xinterface/OpenBCI_ESP32/Firmware/HardwareTests/OpenBCI-ESP32-WiFi-master/README.md

Combined Cyton and WiFi Shield functionality on a single ESP32, replacing the conventional BLE-Serial interface with built-in WiFi.

Required Boards and Libraries:

Arduino-ESP32: https://github.com/espressif/arduino-esp32

ArduinoJson: https://github.com/bblanchon/ArduinoJson
