xinterface/OpenBCI_ESP32/Case/Battery.stl

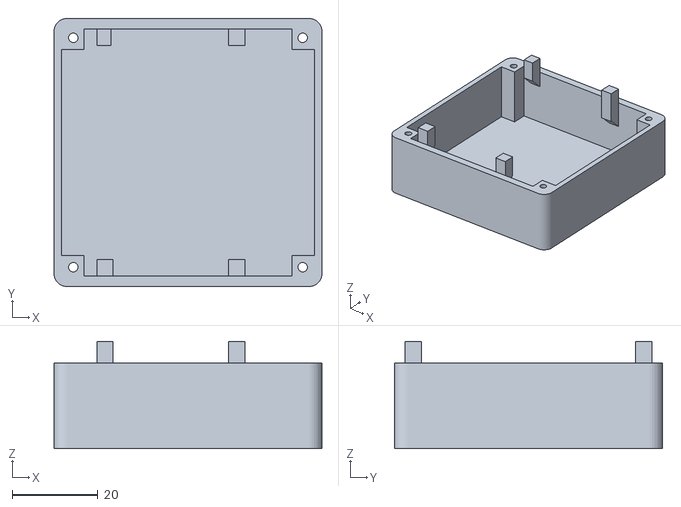
[picture p1: CAD file, 2023-03-15]
Case/Battery.stl
62.5 x 62.5 x 25.0
