xinterface/OpenBCI_ESP32/Case/Switch.stl

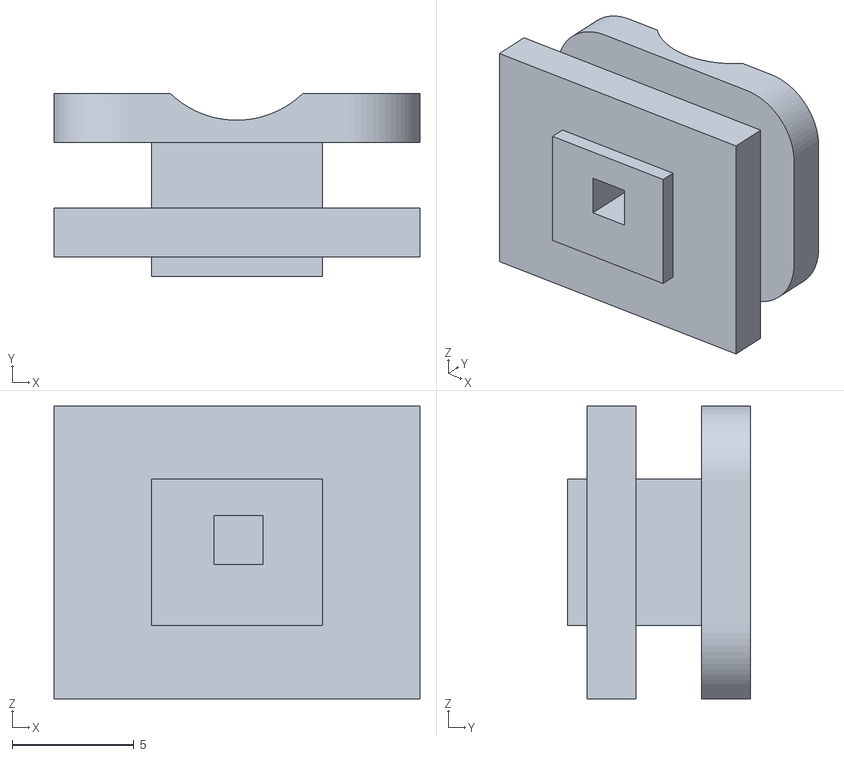
[picture p2: CAD file, 2023-03-15]
Case/Switch.stl
15.0 x 7.50 x 12.0
