xinterface/OpenBCI_ESP32/Case/Base.stl

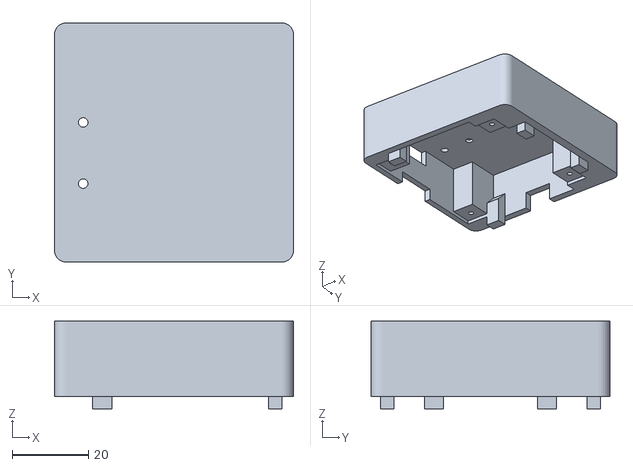
[picture p3: CAD file, 2023-03-15]
Case/Base.stl
62.5 x 62.5 x 22.9
