xinterface/OpenBCI_ESP32/OpenBCI_ESP32_BASE/OpenBCI_ESP32_BASE.kicad_pcb

## KiCad design OpenBCI_ESP32_BASE/OpenBCI_ESP32_BASE.kicad_pcb (2023-03-15)

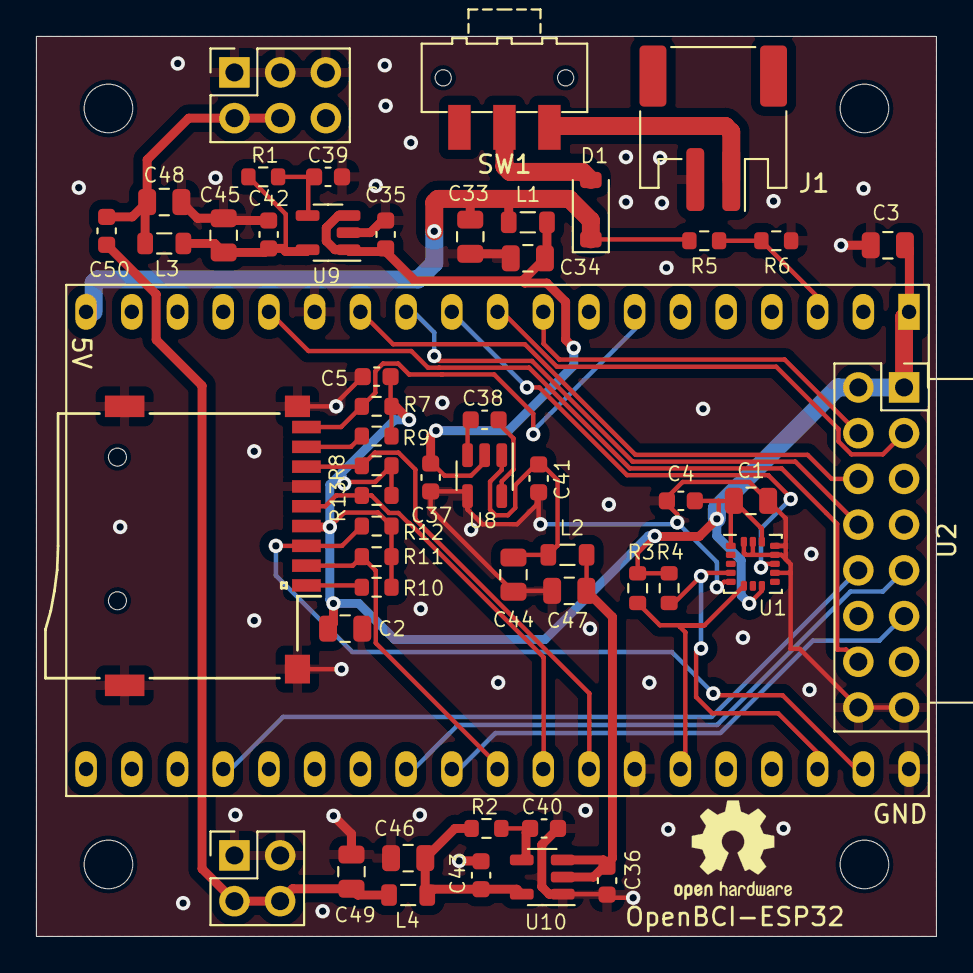
[picture p4: board OpenBCI_ESP32_BASE.kicad_pcb from above]

Board: 2 copper layers, 50.0 x 50.0 mm, 57 parts (0 on the bottom side), 33 nets.

Parts:
C1, C2, C3, C33, C34, C44, C45, C46, C47, C48, C49: 10u; C_0805_2012Metric
C4, C5, C50: 0.1u; C_0603_1608Metric
C35, C37, C38, C39, C41: 1u; C_0603_1608Metric
C36, C42, C43: 2.2u; C_0603_1608Metric
C40: 10n; C_0603_1608Metric
D1: D_Schottky; D_SOD-123
H1, H2, H3, H4: MountingHole; MountingHole_2.7mm_M2.5
J1: Conn_01x02; JST_PH_S2B-PH-SM4-TB_1x02-1MP_P2.00mm_Horizontal
J2: Conn_02x03_Odd_Even; PinHeaderReverse_2x03_P2.54mm_OpenBCI
J3: Conn_02x02_Odd_Even; PinHeaderReverse_2x02_P2.54mml_OpenBCI
J4: Conn_02x08_Odd_Even; PinHeaderReverse_2x08_P2.54mm_OpenBCI
L1, L2, L3, L4: 3.3u; L_0805_2012Metric
LOGO1: Logo_Open_Hardware_Small; OSHW-Logo2_7.3x6mm_SilkScreen
R1, R2: NF; R_0603_1608Metric
R3, R4: 4k7; R_0603_1608Metric
R5: 220k; R_0603_1608Metric
R6: 120k; R_0603_1608Metric
R7, R8, R9, R10, R11, R12, R13: 10k; R_0603_1608Metric
SW1: SW_SPDT; SW_SPDT_CK-JS102011SAQN
U1: LIS3DH; LGA-16_3x3mm_P0.5mm_LayoutBorder3x5y
U2: ESP32-DevKitC
U8: TPS60403; SOT-23-5
U9: TPS73225; SOT-23-5
U10: TPS72325; SOT-23-5
XS1: SD_ebay-uSD-push_push_SMD; Conn_uSDcard

Connections:
+2V5: C48.1, C50.1, J2.2, J2.4, L3.2
+3.3V: C1.1, C2.1, C3.1, C4.1, C5.1, J4.1, J4.2, R3.1, R4.1, R7.1, R8.1, R9.1, R10.1, R11.1, R12.1, R13.1, U1.1 (VDD_IO), U1.8 (CS), U1.14 (VDD), U2.1 (3V3), XS1.4 (Vdd)
+5V: C33.1, D1.1 (K), L1.1, R5.1, U2.19 (5V)
-2V5: C49.1, C50.2, J3.2, J3.4, L4.2
-5V: C36.1, C47.1, L2.2, U10.2 (Vin), U10.3 (EN)
/OpenBCI_ESP_DEVKIT/ADSCLK: J4.8, U2.12 (MTMS/GPIO14/ADC2_CH6)
/OpenBCI_ESP_DEVKIT/ADSCS1: J4.10, U2.23 (*MTDO/GPIO15/ADC2_CH3)
/OpenBCI_ESP_DEVKIT/ADSCS2: J4.9, U2.27 (GPIO16)
/OpenBCI_ESP_DEVKIT/ADSDRDY1: J4.4, U2.9 (DAC_1/ADC2_CH8/GPIO25)
/OpenBCI_ESP_DEVKIT/ADSDRDY2: J4.3, U2.10 (DAC_2/ADC2_CH9/GPIO26)
/OpenBCI_ESP_DEVKIT/ADSMISO: J4.6, U2.13 (*MTDI/GPIO12/ADC2_CH5)
/OpenBCI_ESP_DEVKIT/ADSMOSI: J4.14, U2.15 (MTCK/GPIO13/ADC2_CH4)
/OpenBCI_ESP_DEVKIT/ADSRST: J4.11, U2.28 (GPIO17)
/OpenBCI_ESP_DEVKIT/INT1: U1.11 (INT1), U2.11 (ADC2_CH7/GPIO27)
/OpenBCI_ESP_DEVKIT/SCL: R4.2, U1.4 (SCL/SPC), U2.36 (GPIO22)
/OpenBCI_ESP_DEVKIT/SDA: R3.2, U1.6 (SDA/SDI/SDO), U2.33 (GPIO21)
/OpenBCI_ESP_DEVKIT/SDCD: R7.2, U2.7 (32K_XP/GPIO32/ADC1_CH4), XS1.9 (CD)
/OpenBCI_ESP_DEVKIT/SDCLK: R13.2, U2.30 (GPIO18), XS1.5 (CLK)
/OpenBCI_ESP_DEVKIT/SDCS: R11.2, U2.29 (*GPIO5), XS1.2 (CS/DAT3)
/OpenBCI_ESP_DEVKIT/SDMISO: R8.2, U2.31 (GPIO19), XS1.7 (DO/DAT0)
/OpenBCI_ESP_DEVKIT/SDMOSI: R12.2, U2.37 (GPIO23), XS1.3 (DI/CMD)
GND: C1.2, C2.2, C3.2, C4.2, C5.2, C33.2, C34.2, C35.2, C36.2, C37.2, C39.2, C40.2, C41.2, C42.2, C43.2, C44.2, C45.2, C46.2, C47.2, C48.2, C49.2, J1.2, J2.1, J2.3, J2.5, J3.1, J3.3, J4.15, J4.16, R6.2, U1.5 (GND), U1.10 (GND), U1.12 (GND), U1.13 (ADC3), U1.15 (ADC2), U1.16 (ADC1), U2.14 (GND), U2.32 (GND), U2.38 (GND), U8.4 (Gnd), U9.2 (Gnd), U10.1 (Gnd), XS1.6 (GND)
unnamed: D1.2 (A), SW1.2 (B)
unnamed: J1.1, SW1.1 (A)
unnamed: R5.2, R6.1, U2.3 (SENSOR_VP/GPIO36/ADC1_CH0)
unnamed: C38.1, U8.3 (Cfly1)
unnamed: C38.2, U8.5 (Cfly2)
unnamed: C34.1, C35.1, C37.1, L1.2, U8.2 (Vin), U9.1 (Vin), U9.3 (EN)
unnamed: C41.1, C44.1, L2.1, U8.1 (Vout)
unnamed: C39.1, R1.2, U9.4 (NR)
unnamed: C42.1, C45.1, L3.1, R1.1, U9.5 (Vout)
unnamed: C40.1, R2.2, U10.4 (NR)
unnamed: C43.1, C46.1, L4.1, R2.1, U10.5 (Vout)
