xinterface/OpenBCI_ESP32/OpenBCI_ESP32_ADS1298/OpenBCI_ESP32_ADS1298.kicad_pcb

## KiCad design OpenBCI_ESP32_ADS1298/OpenBCI_ESP32_ADS1298.kicad_pcb (2023-03-15)

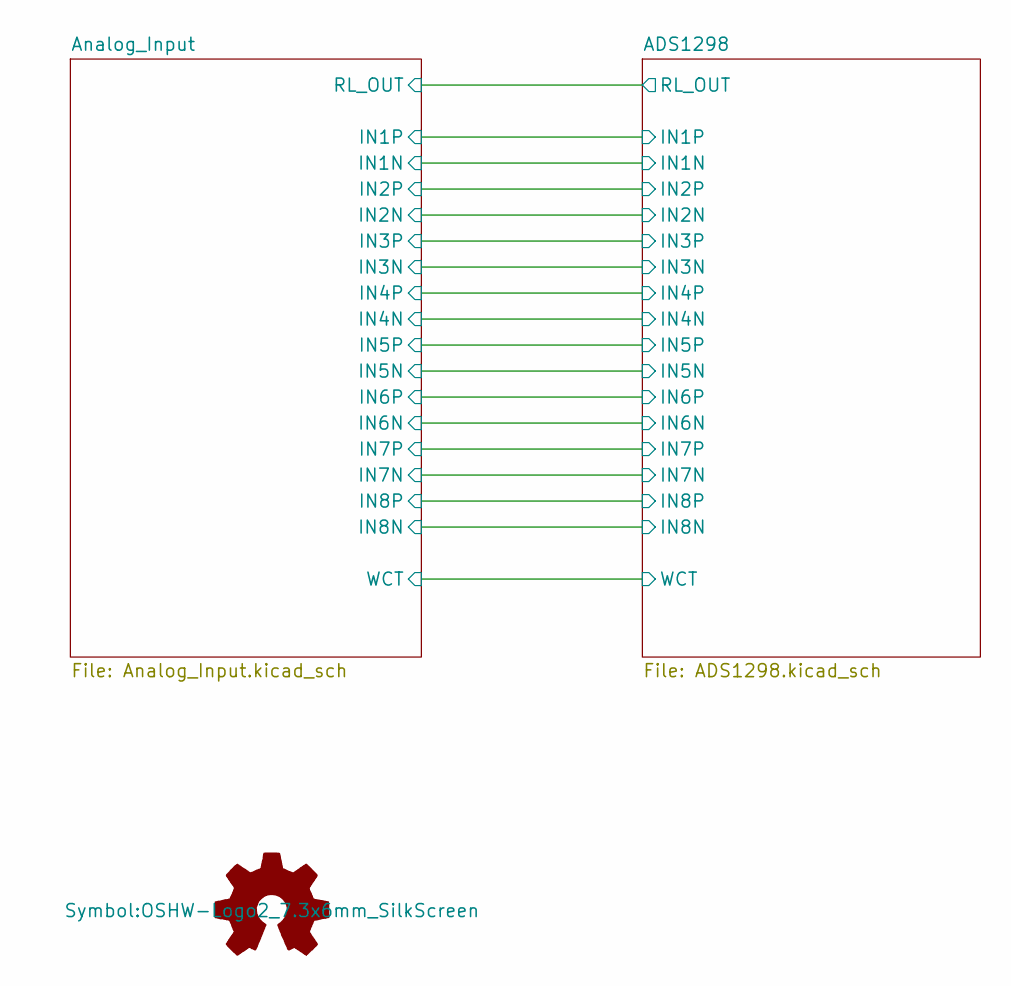
[picture p9: schematic OpenBCI_ESP32_ADS1298.kicad_sch]

Parts:
LOGO1: Logo_Open_Hardware_Small; OSHW-Logo2_7.3x6mm_SilkScreen

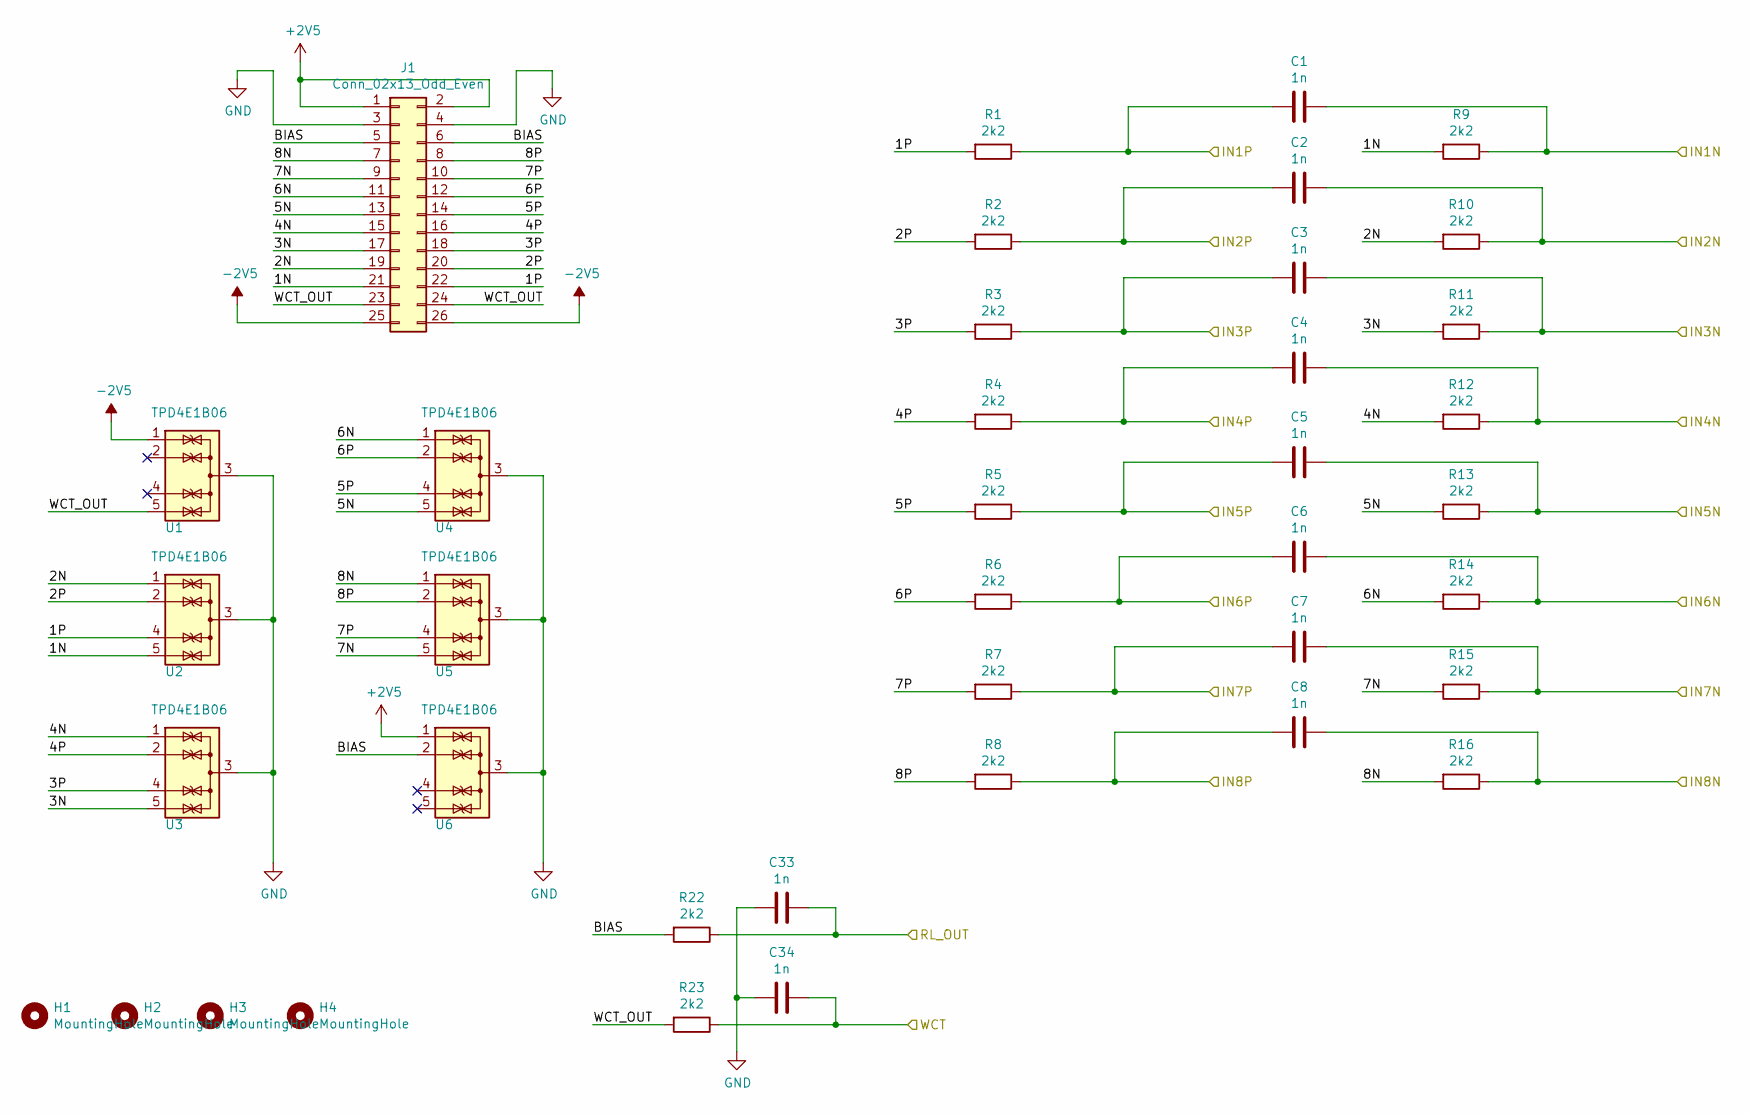
[picture p10: schematic Analog_Input.kicad_sch]

Parts:
C1, C2, C3, C4, C5, C6, C7, C8, C33, C34: 1n; C_0603_1608Metric
H1, H2, H3, H4: MountingHole; MountingHole_2.7mm_M2.5
J1: Conn_02x13_Odd_Even; PinHeader_2x13_P2.54mm_OpenBCI
R1, R2, R3, R4, R5, R6, R7, R8, R9, R10, R11, R12, R13, R14, R15, R16, R22, R23: 2k2; R_0603_1608Metric
U1, U2, U3, U4, U5, U6: TPD4E1B06; SOT-363_SC-70-6

Connections:
+2V5: J1.1, J1.2, U6.1 (IO1); also elsewhere on the board
-2V5: J1.25, J1.26, U1.1 (IO1); also elsewhere on the board
/ADS1298/IN1N: C1.1, R9.1; also elsewhere on the board
/ADS1298/IN1P: C1.2, R1.1; also elsewhere on the board
/ADS1298/IN2N: C2.1, R10.1; also elsewhere on the board
/ADS1298/IN2P: C2.2, R2.1; also elsewhere on the board
/ADS1298/IN3N: C3.1, R11.1; also elsewhere on the board
/ADS1298/IN3P: C3.2, R3.1; also elsewhere on the board
/ADS1298/IN4N: C4.1, R12.1; also elsewhere on the board
/ADS1298/IN4P: C4.2, R4.1; also elsewhere on the board
/ADS1298/IN5N: C5.1, R13.1; also elsewhere on the board
/ADS1298/IN5P: C5.2, R5.1; also elsewhere on the board
/ADS1298/IN6N: C6.1, R14.1; also elsewhere on the board
/ADS1298/IN6P: C6.2, R6.1; also elsewhere on the board
/ADS1298/IN7N: C7.1, R15.1; also elsewhere on the board
/ADS1298/IN7P: C7.2, R7.1; also elsewhere on the board
/ADS1298/IN8N: C8.1, R16.1; also elsewhere on the board
/ADS1298/IN8P: C8.2, R8.1; also elsewhere on the board
/ADS1298/RL_OUT: C33.1, R22.1; also elsewhere on the board
/ADS1298/WCT: C34.1, R23.1; also elsewhere on the board
/Analog_Input/1N: J1.21, R9.2, U2.5 (IO4)
/Analog_Input/1P: J1.22, R1.2, U2.4 (IO3)
/Analog_Input/2N: J1.19, R10.2, U2.1 (IO1)
/Analog_Input/2P: J1.20, R2.2, U2.2 (IO2)
/Analog_Input/3N: J1.17, R11.2, U3.5 (IO4)
/Analog_Input/3P: J1.18, R3.2, U3.4 (IO3)
/Analog_Input/4N: J1.15, R12.2, U3.1 (IO1)
/Analog_Input/4P: J1.16, R4.2, U3.2 (IO2)
/Analog_Input/5N: J1.13, R13.2, U4.5 (IO4)
/Analog_Input/5P: J1.14, R5.2, U4.4 (IO3)
/Analog_Input/6N: J1.11, R14.2, U4.1 (IO1)
/Analog_Input/6P: J1.12, R6.2, U4.2 (IO2)
/Analog_Input/7N: J1.9, R15.2, U5.5 (IO4)
/Analog_Input/7P: J1.10, R7.2, U5.4 (IO3)
/Analog_Input/8N: J1.7, R16.2, U5.1 (IO1)
/Analog_Input/8P: J1.8, R8.2, U5.2 (IO2)
/Analog_Input/BIAS: J1.5, J1.6, R22.2, U6.2 (IO2)
/Analog_Input/WCT_OUT: J1.23, J1.24, R23.2, U1.5 (IO4)
GND: C33.2, C34.2, J1.3, J1.4, U1.3 (G), U2.3 (G), U3.3 (G), U4.3 (G), U5.3 (G), U6.3 (G); also elsewhere on the board

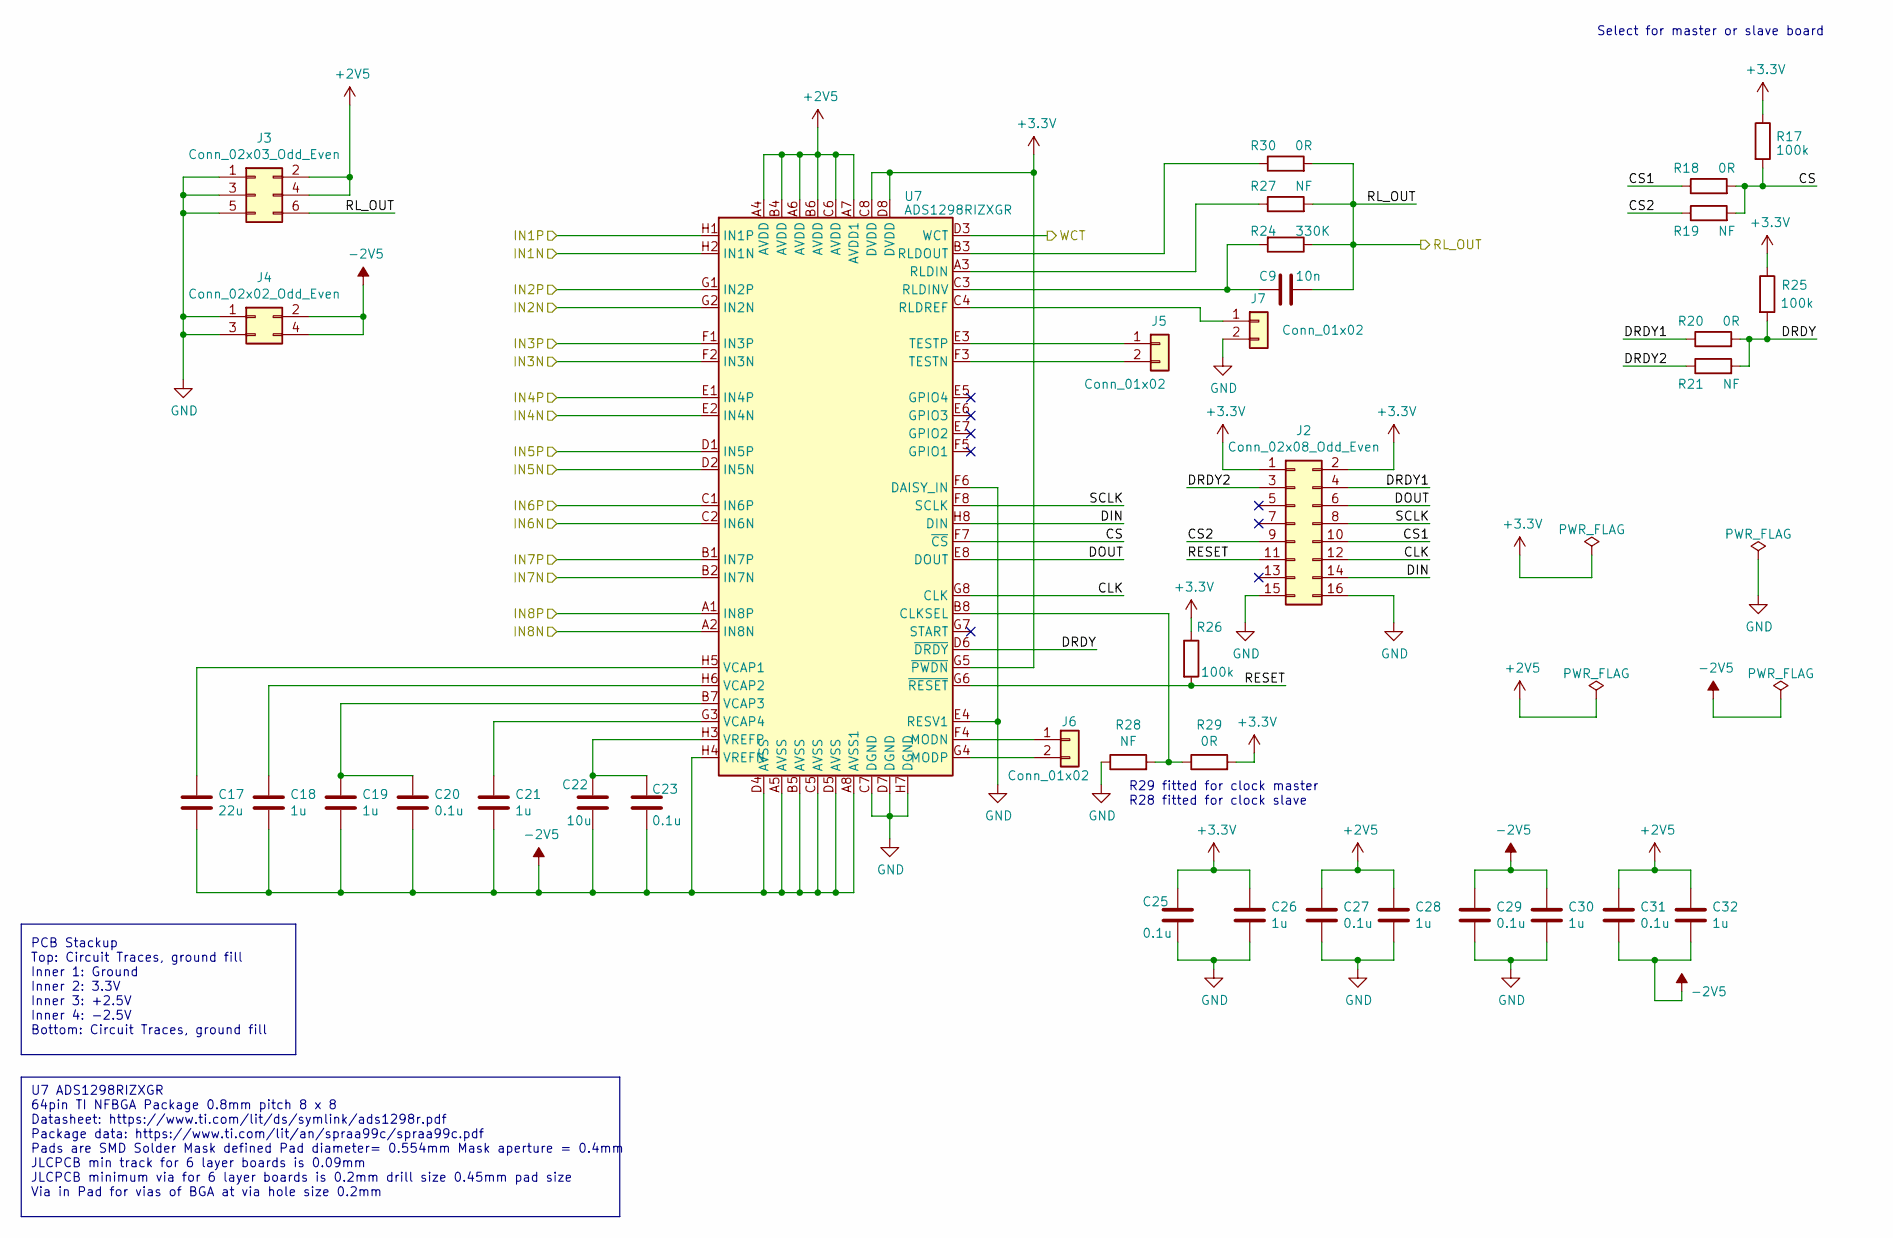
[picture p11: schematic ADS1298.kicad_sch]

Parts:
C9: 10n; C_0603_1608Metric
C17: 22u; C_0805_2012Metric
C18, C19, C21, C26, C28, C30, C32: 1u; C_0603_1608Metric
C20, C23, C25, C27, C29, C31: 0.1u; C_0603_1608Metric
C22: 10u; C_0805_2012Metric
J2: Conn_02x08_Odd_Even; PinSocket_2x08_P2.54mm_Vertical
J3: Conn_02x03_Odd_Even; PinSocket_2x03_P2.54mm_Vertical
J4: Conn_02x02_Odd_Even; PinSocket_2x02_P2.54mm_Vertical
J5, J6, J7: Conn_01x02; PinHeader_1x02_P2.00mm_Vertical
R17, R25, R26: 100k; R_0603_1608Metric
R18, R20, R29, R30: 0R; R_0603_1608Metric
R19, R21, R27, R28: NF; R_0603_1608Metric
R24: 330K; R_0603_1608Metric
U7: ADS1298RIZXGR; BGA-64_8x8_8.0x8.0mm

Connections:
+2V5: C27.1, C28.1, C31.1, C32.1, J3.2, J3.4, U7.A4 (AVDD), U7.A6 (AVDD), U7.A7 (AVDD1), U7.B4 (AVDD), U7.B6 (AVDD), U7.C6 (AVDD); also elsewhere on the board
+3.3V: C25.1, C26.1, J2.1, J2.2, R17.1, R25.1, R26.1, R29.2, U7.C8 (DVDD), U7.D8 (DVDD), U7.G5 (~PWDN)
-2V5: C17.2, C18.2, C19.2, C20.2, C21.2, C22.2, C23.2, C29.1, C30.1, C31.2, C32.2, J4.2, J4.4, U7.A5 (AVSS), U7.A8 (AVSS1), U7.B5 (AVSS), U7.C5 (AVSS), U7.D4 (AVSS), U7.D5 (AVSS), U7.H4 (VREFN); also elsewhere on the board
/ADS1298/CLK: J2.12, U7.G8 (CLK)
/ADS1298/CS: R17.2, R18.2, R19.2, U7.F7 (~CS)
/ADS1298/CS1: J2.10, R18.1
/ADS1298/CS2: J2.9, R19.1
/ADS1298/DIN: J2.14, U7.H8 (DIN)
/ADS1298/DOUT: J2.6, U7.E8 (DOUT)
/ADS1298/DRDY: R20.2, R21.2, R25.2, U7.D6 (~DRDY)
/ADS1298/DRDY1: J2.4, R20.1
/ADS1298/DRDY2: J2.3, R21.1
/ADS1298/IN1N: U7.H2 (IN1N); also elsewhere on the board
/ADS1298/IN1P: U7.H1 (IN1P); also elsewhere on the board
/ADS1298/IN2N: U7.G2 (IN2N); also elsewhere on the board
/ADS1298/IN2P: U7.G1 (IN2P); also elsewhere on the board
/ADS1298/IN3N: U7.F2 (IN3N); also elsewhere on the board
/ADS1298/IN3P: U7.F1 (IN3P); also elsewhere on the board
/ADS1298/IN4N: U7.E2 (IN4N); also elsewhere on the board
/ADS1298/IN4P: U7.E1 (IN4P); also elsewhere on the board
/ADS1298/IN5N: U7.D2 (IN5N); also elsewhere on the board
/ADS1298/IN5P: U7.D1 (IN5P); also elsewhere on the board
/ADS1298/IN6N: U7.C2 (IN6N); also elsewhere on the board
/ADS1298/IN6P: U7.C1 (IN6P); also elsewhere on the board
/ADS1298/IN7N: U7.B2 (IN7N); also elsewhere on the board
/ADS1298/IN7P: U7.B1 (IN7P); also elsewhere on the board
/ADS1298/IN8N: U7.A2 (IN8N); also elsewhere on the board
/ADS1298/IN8P: U7.A1 (IN8P); also elsewhere on the board
/ADS1298/RESET: J2.11, R26.2, U7.G6 (~RESET)
/ADS1298/RL_OUT: C9.2, J3.6, R24.1, R27.2, R30.2; also elsewhere on the board
/ADS1298/SCLK: J2.8, U7.F8 (SCLK)
/ADS1298/WCT: U7.D3 (WCT); also elsewhere on the board
GND: C25.2, C26.2, C27.2, C28.2, C29.2, C30.2, J2.15, J2.16, J3.1, J3.3, J3.5, J4.1, J4.3, J7.2, R28.1, U7.C7 (DGND), U7.D7 (DGND), U7.E4 (RESV1), U7.F6 (DAISY_IN), U7.H7 (DGND); also elsewhere on the board
unnamed: J5.1, U7.E3 (TESTP)
unnamed: J5.2, U7.F3 (TESTN)
unnamed: J6.1, U7.F4 (MODN)
unnamed: J6.2, U7.G4 (MODP)
unnamed: J7.1, U7.C4 (RLDREF)
unnamed: R28.2, R29.1, U7.B8 (CLKSEL)
unnamed: R27.1, U7.A3 (RLDIN)
unnamed: C9.1, R24.2, U7.C3 (RLDINV)
unnamed: R30.1, U7.B3 (RLDOUT)
unnamed: C17.1, U7.H5 (VCAP1)
unnamed: C18.1, U7.H6 (VCAP2)
unnamed: C19.1, C20.1, U7.B7 (VCAP3)
unnamed: C21.1, U7.G3 (VCAP4)
unnamed: C22.1, C23.1, U7.H3 (VREFP)

Notes on the sheet:
R29 fitted for clock master R28 fitted for clock slave
Select for master or slave board
U7 ADS1298RIZXGR 64pin TI NFBGA Package 0.8mm pitch 8 x 8 Datasheet: https://www.ti.com/lit/ds/symlink/ads1298r.pdf Package data: https://www.ti.com/lit/an/spraa99c/spraa99c.pdf Pads are SMD Solder Mask defined Pad diameter= 0.554mm Mask aperture = 0.4mm JLCPCB min track for 6 layer boards is 0.09m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
PCB Stackup Top: Circuit Traces, ground fill Inner 1: Ground Inner 2: 3.3V Inner 3: +2.5V Inner 4: -2.5V Bottom: Circuit Traces, ground fill

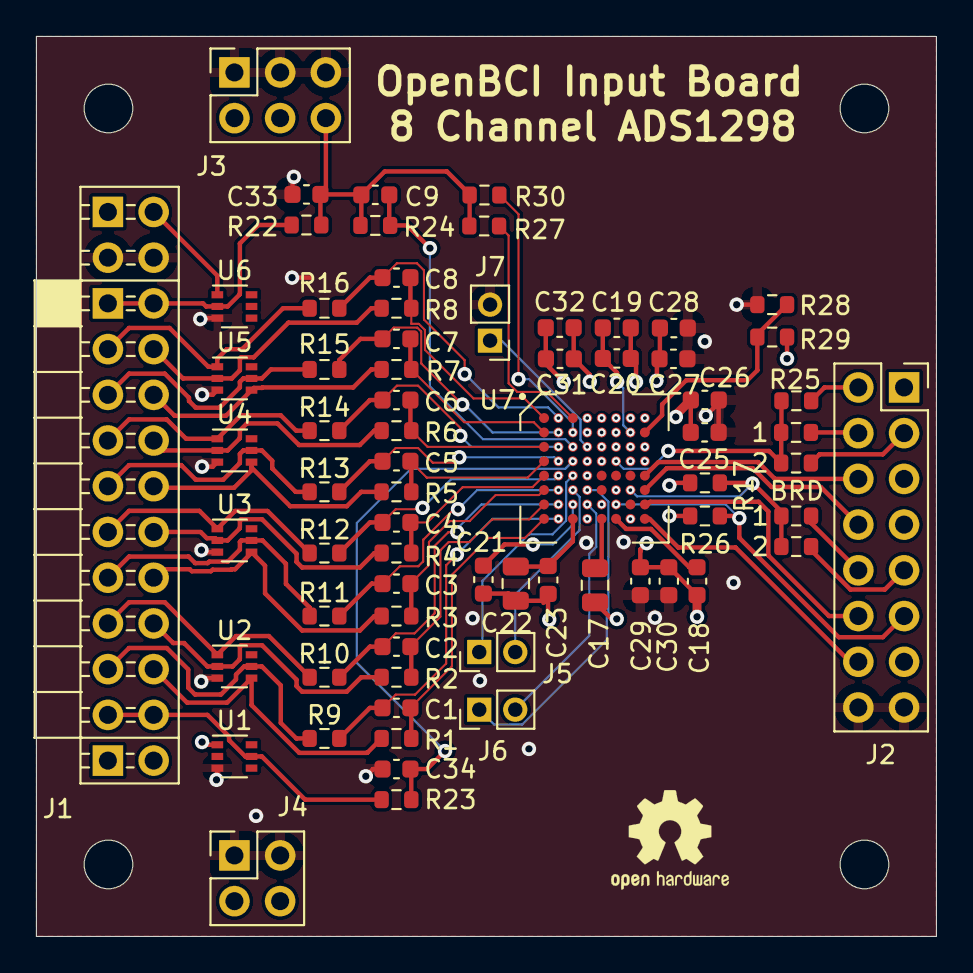
[picture p12: board OpenBCI_ESP32_ADS1298.kicad_pcb from above]

Board: 6 copper layers, 50.0 x 50.0 mm, 75 parts (0 on the bottom side), 65 nets.
